dcamacho16/sdp-minihvac/docs/02-plant-model.md

# MiniHVAC_Zone Module: Physical Zone Model

## 1. Module Purpose

The **MiniHVAC_Zone** block implements the **simplified physical model** of the thermal, humidity, and airflow/ventilation dynamics of a conditioned zone.  

This module is part of the project’s **modular implementation** phase and has the following objectives:

- Continuously and simply represent the evolution of:
  - Room temperature (`T_sim`)
  - Room relative humidity (`RH_sim`)
  - Flow/“symbolic pressure” associated with the fan (`P_sim`)
- Enable **isolated validation** of the physical behavior before integrating:
  - The control logic (`Thermostat_Logic`, `Control_Simulink`)
  - The interface with the ESP32 (`ESP32_Interface`)
  - The alarm logic (`Alarms_Logic`)

---

## 2. Module Interface

The `MiniHVAC_Zone` block is implemented as a Simulink **subsystem** with the following ports:

### 2.1 Inputs (Inports)

- `T_amb`  
  Ambient temperature (°C). Represents the external environment or reference conditions.

- `RH_amb`  
  Ambient relative humidity (%). Humidity reference condition.

- `u_fan_cmd`  
  Fan command signal (dimensionless, typical range 0–1).  
  - 0 → fan off  
  - 1 → fan at 100 %  

- `u_heater_cmd`  
  Heater command signal (dimensionless, typical range 0–1).  
  - 0 → heater off  
  - 1 → heater at nominal power  

- `u_humid_cmd`  
  Humidifier command signal (dimensionless, typical range 0–1).  
  - 0 → humidifier off  
  - 1 → maximum humidity contribution  

### 2.2 Outputs (Outports)

- `T_sim`  
  Simulated room temperature (°C). Output of the thermal model.

- `RH_sim`  
  Simulated room relative humidity (%). Output of the humidity model.

- `P_sim`  
  Symbolic “pressure/flow” magnitude generated by the fan (arbitrary units), useful as an indicator of airflow or fan activity.

---

## 3. Implemented Physical Model

The module implements three submodels:

1. **Thermal model** (temperature)
2. **Humidity model** (relative humidity)
3. **Symbolic pressure/flow model**

The goal is not to build an exact industrial HVAC model, but rather a **simplified dynamic model** with a smooth response and tunable parameters, to be used as a test bench for the control algorithms.

### 3.1 Temperature Dynamics

The room temperature is modeled as a first-order system with heating input, thermal losses to the environment, and the effect of ventilation:

$$
C \, \frac{dT}{dt} = P_{heater} \, u_{heater} - k_{loss} \, (T - T_{amb}) - k_{fan} \, u_{fan} \, (T - T_{amb})
$$

where:

- $T$ : room temperature (ºC) → `T_sim`
- $T_{amb}$ : ambient temperature (ºC) → `T_amb`
- $C$ : effective thermal capacity of the room  
- $P_{heater}$ : nominal heater power
- $k_{loss}$ : thermal loss coefficient to the environment
- $k_{fan}$ : forced-exchange coefficient due to the fan
- $u_{heater}$ : heater command → `u_heater_cmd`
- $u_{fan}$ : fan command → `u_fan_cmd`

Rearranging:

$$
\frac{dT}{dt} = \frac{1}{C} \left[
P_{heater} \, u_{heater}
- k_{loss} (T - T_{amb})
- k_{fan} \, u_{fan} (T - T_{amb})
\right]
$$

In Simulink, this equation is implemented as follows:

- **Integrator**: integrates $\frac{dT}{dt}$ and outputs `T_sim`.
- Calculation of $T - T_{amb}$ using a `Sum` block of type `+ -`.
- Gains representing:
  - Thermal losses: $-k_{loss}(T - T_{amb})$
  - Fan effect: $-k_{fan} \, u_{fan} (T - T_{amb})$
- Positive heater gain: $P_{heater} \, u_{heater}$
- Sum of all contributions (heating–losses–ventilation) and multiplication by $1/C$.

#### Typical Values Used

The parameters can be adjusted according to the desired behavior. During the validation phase, values on the order of the following were tested:

- $C \in [20, 40]$  
- $k_{loss} \approx 0.05 - 0.1$
- $k_{fan} \approx 0.3 - 0.5$
- $P_{heater} \approx 5 - 15$

These ranges provide noticeable dynamics in 100–300 s simulations.

---

### 3.2 Relative Humidity Dynamics

The room relative humidity is modeled as a first-order system that tends toward ambient humidity, with an additional contribution from the humidifier:

$$
\frac{dRH}{dt} = -\frac{1}{\tau} (RH - RH_{amb}) + k_{humid} \, u_{humid}
$$

where:

- $RH$ : room relative humidity (%) → `RH_sim`
- $RH_{amb}$ : ambient relative humidity (%) → `RH_amb`
- $\tau$ : time constant for humidity exchange with the environment
- $k_{humid}$ : humidifier gain
- $u_{humid}$ : humidifier command → `u_humid_cmd`

In Simulink, the structure is analogous to the thermal model:

- **Integrator**: integrates $\frac{dRH}{dt}$ and outputs `RH_sim`.
- Calculation of $RH - RH_{amb}$ with a `Sum` block.
- Relaxation term toward the environment: $-\frac{1}{\tau}(RH - RH_{amb})$.
- Humidity contribution term: $k_{humid} \, u_{humid}$.

#### Typical Values Used

- $\tau \approx 30 - 60$ s  
- $k_{humid} \approx 0.1 - 0.3$

These values make it easy to observe convergence toward `RH_amb` and the increase in humidity when the humidifier is active.

---

### 3.3 Symbolic Pressure / Flow Dynamics

To provide a simple measure of fan activity, a symbolic magnitude $P_{sim}$ is defined:

$$
P_{sim} = k_{P} \, u_{fan}
$$

- `P_sim` is implemented with a `Gain` block that multiplies `u_fan_cmd`.
- $k_P$ can be set, for example, in the range 1–5 for visualization in the `Scope`.

This output is not intended to be an exact physical pressure measurement, but rather an airflow/ventilation indicator useful for debugging and visualization.

---

## 4. Subsystem Configuration in Simulink

For the validation phase, the `MiniHVAC_Zone` block was tested in a dedicated test model with the following recommended configuration:

- **Solver type**: Fixed-step  
- **Solver**: for example `ode3` or `ode4`
- **Integration step**: `Ts = 0.1 s`
- **Simulation time**: typically `StopTime = 200 s` (adjustable depending on the test case)

The differential equations are integrated continuously using `Integrator` blocks, which makes it possible to observe the smooth evolution of `T_sim` and `RH_sim`.

---

## 5. Module Unit Tests

Within the framework of Phase 2 (“modular implementation”), a set of **unit tests** was designed to validate the model behavior before integrating it with the rest of the subsystems.

Each test consists of:

- Connecting the `MiniHVAC_Zone` block to a set of `Constant` blocks.
- Visualizing the outputs (`T_sim`, `RH_sim`, `P_sim`) with `Scope`.
- Adjusting the initial conditions of the integrators (initial room temperature and humidity).

### 5.1 Test 1: Baseline Case Without Actuators

**Objective:** verify that, in the absence of actuators, the room remains at ambient conditions.

- `T_amb = 22 °C`
- `RH_amb = 50 %`
- `u_fan_cmd = 0`
- `u_heater_cmd = 0`
- `u_humid_cmd = 0`
- Initial conditions:
  - `T_sim(0) = 22 °C`
  - `RH_sim(0) = 50 %`

**Expected behavior:**

- `T_sim` remains approximately constant at 22 °C.
- `RH_sim` remains approximately constant at 50 %.
- `P_sim = 0` (fan off).

This test confirms that the model does not introduce spurious dynamics when the system is in equilibrium with the environment.

---

### 5.2 Test 2: Passive Cooling (Without Fan)

**Objective:** validate thermal losses to the environment with the fan turned off.

- `T_amb = 22 °C`
- `u_heater_cmd = 0`
- `u_fan_cmd = 0`
- `u_humid_cmd = 0`
- Initial condition:
  - `T_sim(0) = 28 °C` (> `T_amb`)

**Expected behavior:**

- `T_sim` decreases smoothly from 28 °C toward 22 °C.
- The cooling rate depends on $C$ and $k_{loss}$.
- `RH_sim` remains at the initial test condition (if no difference with `RH_amb` is forced in this scenario).
- `P_sim = 0`.

This test verifies that the loss term $-k_{loss}(T - T_{amb})$ is correctly implemented and has the correct sign.

---

### 5.3 Test 3: Fan Effect

**Objective:** verify that the fan accelerates cooling when the room temperature is higher than the ambient temperature.

- `T_amb = 22 °C`
- `u_heater_cmd = 0`
- `u_fan_cmd = 1`
- `u_humid_cmd = 0`
- Initial condition:
  - `T_sim(0) = 28 °C`

**Expected behavior:**

- `T_sim` decreases toward 22 °C **faster** than in Test 2.
- Comparing the `T_sim` curves from Tests 2 and 3 clearly shows the additional effect of $-k_{fan} u_{fan} (T - T_{amb})$.
- `P_sim` takes a nonzero value (proportional to `u_fan_cmd`), indicating that the fan is active.

In addition, if `T_sim` starts equal to `T_amb`, the term $(T - T_{amb})$ is zero and the fan has no effect on temperature, which is physically consistent.

---

### 5.4 Test 4: Heater On

**Objective:** validate the effect of the heater on the room temperature.

- `T_amb = 22 °C`
- `u_heater_cmd = 1`
- `u_fan_cmd = 0`
- `u_humid_cmd = 0`
- Initial condition:
  - `T_sim(0) = 22 °C`

**Expected behavior:**

- `T_sim` increases from 22 °C, initially with an approximately slope:
  $$
  \left. \frac{dT}{dt} \right|_{t=0} \approx \frac{P_{heater}}{C}
  $$
- As `T_sim` moves away from `T_amb`, the losses $-k_{loss}(T - T_{amb})$ increase in magnitude and tend to limit the temperature increase.
- By adjusting `P_{heater}` and `C`, a useful dynamic response can be obtained for control tests (neither too slow nor unstable).

---

### 5.5 Humidity Tests

**Objective:** validate the convergence of `RH_sim` toward `RH_amb` and the effect of the humidifier.

1. **Relaxation toward ambient humidity**

   - `RH_amb = 50 %`
   - `u_humid_cmd = 0`
   - Initial condition: `RH_sim(0) = 70 %`

   *Expected behavior:* `RH_sim` decreases smoothly from 70 % toward 50 % with an approximate time constant $\tau$.

2. **Humidifier contribution**

   - `RH_amb = 50 %`
   - `u_humid_cmd = 0.5` (for example)
   - Initial condition: `RH_sim(0) = 40 %`

   *Expected behavior:* `RH_sim` increases from 40 %, reaching an equilibrium value that depends on $\tau$ and $k_{humid}$. The system should not diverge; it should stabilize at a humidity level higher than the ambient value.

---

## 6. Connection with Other Project Modules

In Phase 2, `MiniHVAC_Zone` is used **independently** for validation, but it is designed to integrate with the following modules:

- **`Thermostat_Logic`**  
  Generates the reference signals and operating mode (AUTO/MANUAL). Based on the temperature error, it produces logical or continuous commands that will be converted into `u_heater_cmd`, `u_fan_cmd`, and `u_humid_cmd`.

- **`Control_Simulink` (PID or another controller)**  
  Based on the difference between the desired temperature and `T_sim`, it computes analog control signals (for example, normalized PWM) that will be connected directly to the inputs:
  - `u_heater_cmd`
  - `u_fan_cmd`
  - `u_humid_cmd`

- **`ESP32_Interface`**  
  This module will be responsible for sending/receiving measurements and setpoints between the model and the ESP32 (for example, through serial communication or UDP). In the pure simulation phase, `T_sim` and `RH_sim` represent the “measurements” that the microcontroller would read from real sensors.

- **`Alarms_Logic`**  
  This module will be able to use `T_sim`, `RH_sim`, and the command signals to generate alarms (overtemperature, humidity out of range, actuator failure, etc.).

---

## 7. Module Conclusions

- The `MiniHVAC_Zone` block provides a **simplified but configurable physical model** of the thermal and humidity dynamics of an HVAC zone.
- It has been explicitly designed to:
  - Support **modular implementation** in Simulink.
  - Enable isolated **unit tests**, verifying the behavior of each input (fan, heater, humidifier) on the outputs.
  - Serve as the basis for **subsequent integration** with the control logic in Simulink and with the ESP32.

This module constitutes the project’s **physical core**, on which the controllers and the interface with the real hardware will rely in the following phases.
