dcamacho16/sdp-minihvac/schematics/Arquitectura de sistema - diagrama.pdf

┌──────────────────────────┐
│ | Usuario | │
│ • Alumno / Operador | │
│ • Interacción con PC | │
│ • Lectura LCD / LEDs | │
└──────────┬──────────────┘
│
│ (Panel Simulink, LCD, botones)
│
┌─────────────────┴─────────────────┐
│ | Capa de Control | │
│ | (PC con MATLAB/Simulink) | │
│ | │
│ ┌─────────────────────────────┐ │
│ │ | Modelo MiniHVAC_Zone | │ │
│ │ (planta T_sim, RH_sim, P) | │ │
│ └──────────────┬──────────────┘ │
│ | │ T_sim, RH_sim | │
│ ┌──────────────▼──────────────┐ │
│ │ | Thermostat_Logic | │ │
│ │ (setpoints, modos, lógica | │ │
│ │ on/off, estados HVAC) | │ │
│ └──────────────┬──────────────┘ │
│ | │ u_fan_cmd, | │
│ | │ u_heater_cmd, | │
│ | │ u_humid_sim(*) │
│ ┌──────────────▼──────────────┐ │
│ │ | Control_Simulink | │ │
│ │ (PI/PID T y RH, generación │ │
│ │ | de señales de mando) | │ │
│ └──────────────┬──────────────┘ │
│ | │ comandos / ref. │
│ ┌──────────────▼──────────────┐ │
│ │ | Alarms_Logic | │ │
│ │ (detección alarmas, | │ │
│ │ alarm_flag, señales fallo) │ │ │ └──────────────┬──────────────┘ │
│ | │ PcToEsp / Pc←Esp│
│ ┌──────────────▼──────────────┐ │
│ │ | ESP32_Interface | │ │
│ │ (codificación/decodificación│ │ │ │ structs PcToEsp / EspToPc, │ │
│ │ UART Serial) | │ │
│ └──────────────┬──────────────┘ │ └─────────────────│─────────────────┘ │ 24B / 32B UART
│ (PcToEsp / EspToPc)
│

┌─────────────────▼─────────────────┐
│ | Capa Embebida (ESP32) | │
│ | + FreeRTOS | │
│ | │
│ ┌──────────────┐ ┌────────────┐ │
│ │ TaskRX | │ │ TaskTX | │ │
│ │ (UART RX → | │ │ (espState │ │
│ │ pcCmd) | │ │ → UART TX)│ │
│ └──────┬───────┘ └─────┬──────┘ │
│ | │ pcCmd | │ espState│
│ ┌──────▼───────┐ ┌─────▼───────┐│
│ │ TaskSensores │ │ TaskLCD | ││
│ │ (BMP/BME, | │ │ (info T/RH, ││
│ │ DHT11, etc) │ │ modo, alarm││ │ └──────┬───────┘ └─────┬───────┘│
│ | │ T_real,RH_real │ | │
│ | └──────┬─────────┘ | │

│ | │ espState | │
│ | ┌────────▼────────┐ | │
│ | │ | Actuadores | │ | │
│ | │ (ventilador, | │ | │
│ | │ resistencia, | │ | │
│ | │ humidificador) │ | │
│ | └────────┬────────┘ | │
└────────────────│───────────────────┘
│
│ Flujo de calor / humedad / aire
│

┌─────────▼───────────┐
│ | Entorno físico | │
│ | (Mini-HVAC real: │
│ | maqueta, cuarto) │
└─────────────────────┘
