dcamacho16/sdp-minihvac/images/f2-alarms-logic-high-temperature-threshold-scope.png

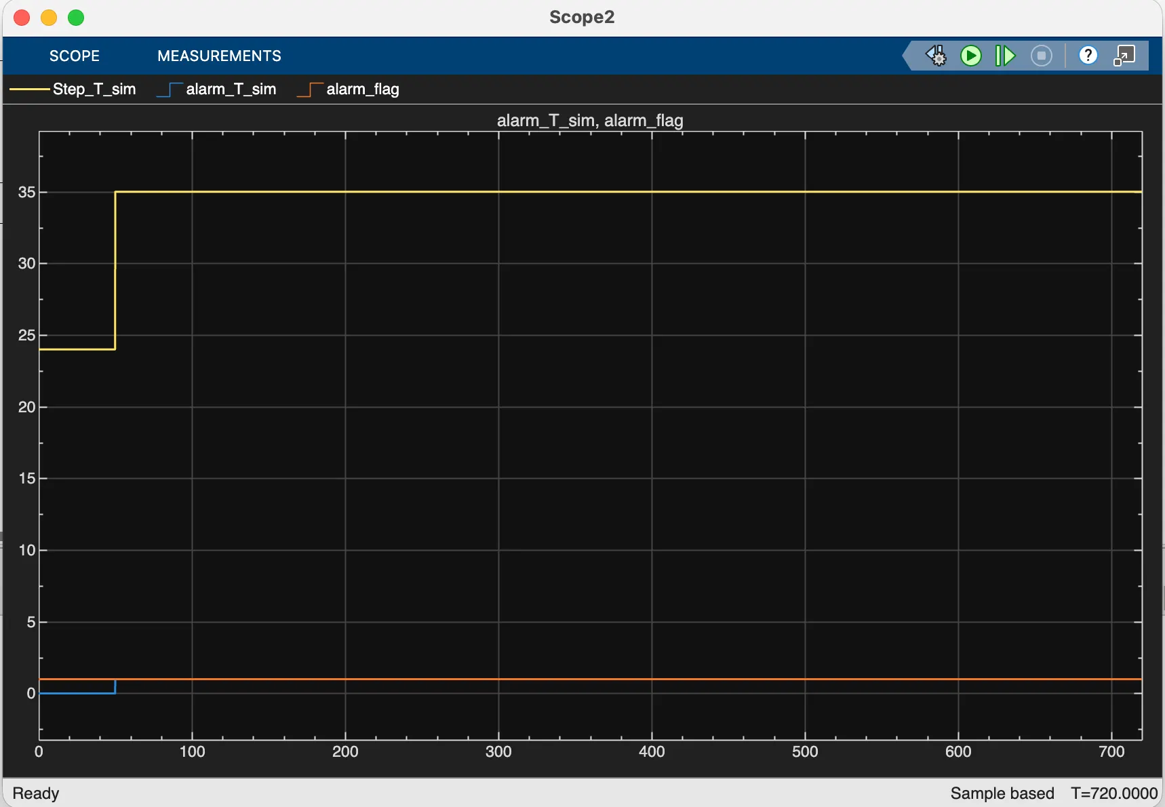
images/f2-alarms-logic-high-temperature-threshold-scope.png
