dcamacho16/sdp-minihvac/images/f2-control-simulink-closed-loop-scope.png

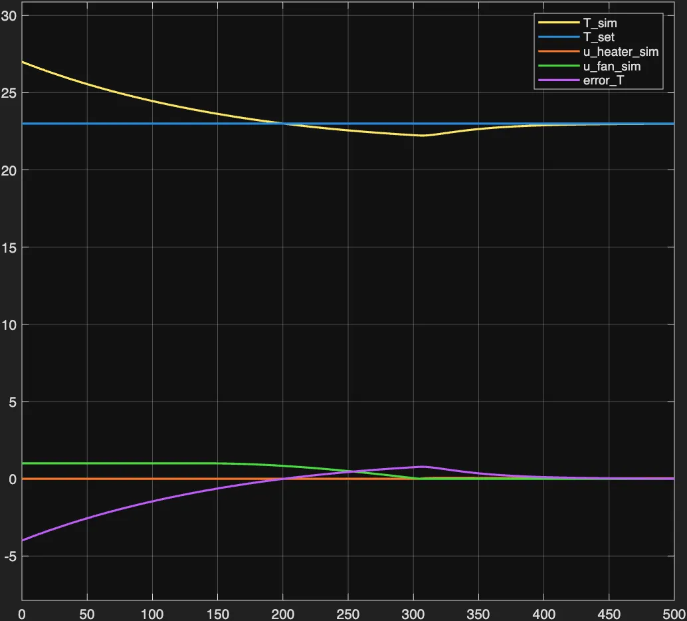
images/f2-control-simulink-closed-loop-scope.png
