dcamacho16/sdp-minihvac/images/f2-control-simulink-temperature-error-correction-scope.png

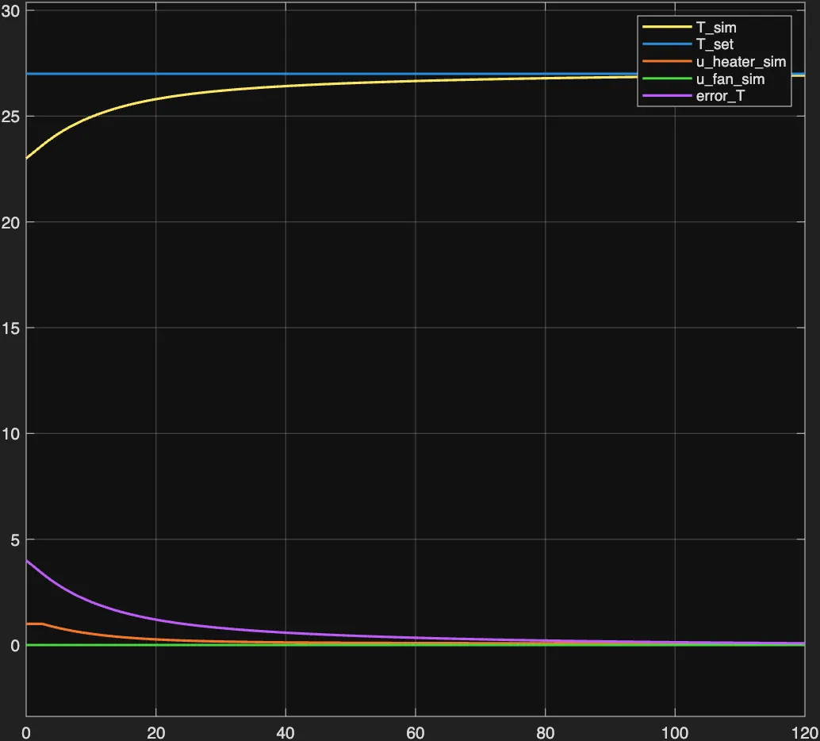
images/f2-control-simulink-temperature-error-correction-scope.png
