dcamacho16/sdp-minihvac/images/f2-freertos-serial-temperature-log.png

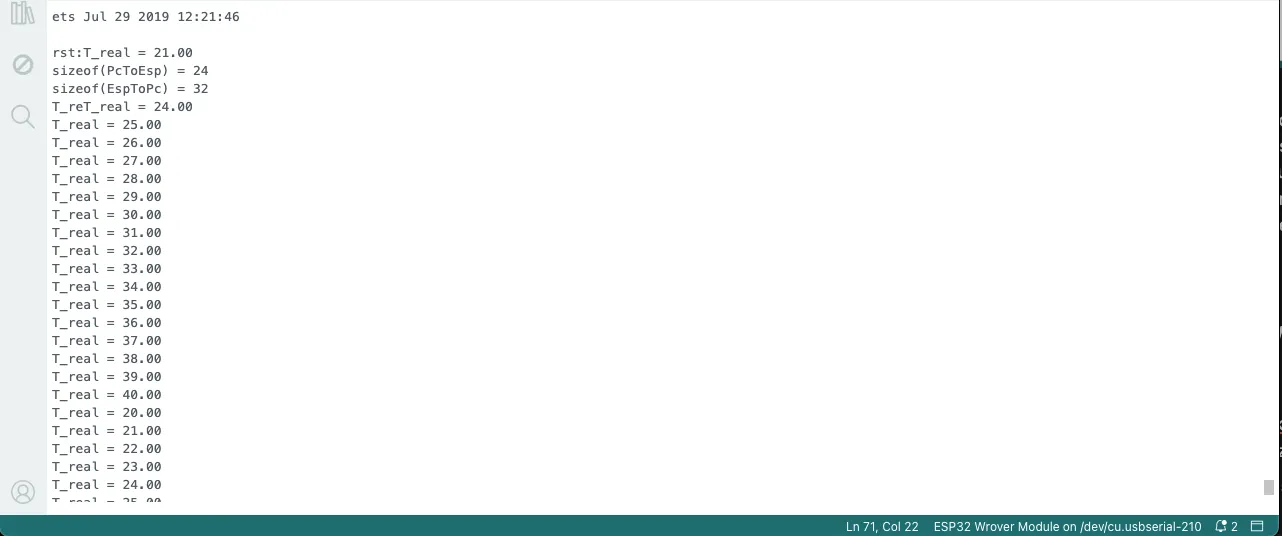
images/f2-freertos-serial-temperature-log.png
