dcamacho16/sdp-minihvac/images/f2-minihvac-zone-fan-effect-scope.png

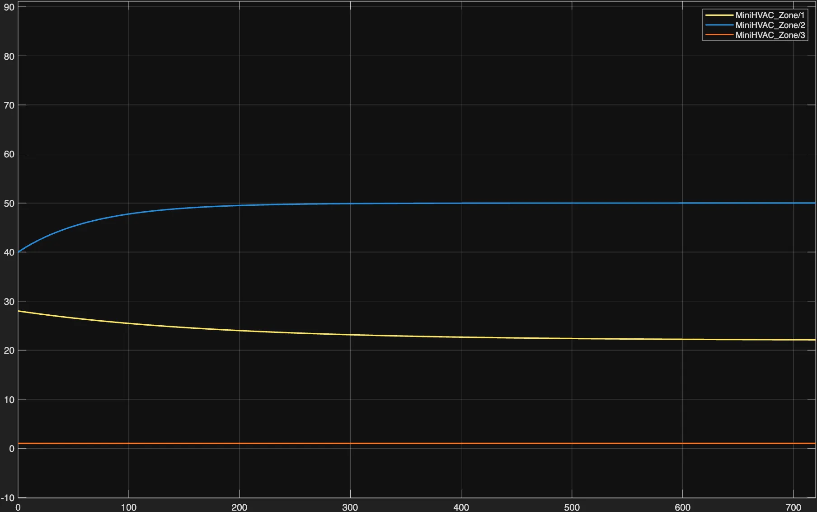
images/f2-minihvac-zone-fan-effect-scope.png
