dcamacho16/sdp-minihvac/images/f2-minihvac-zone-heater-on-scope.png

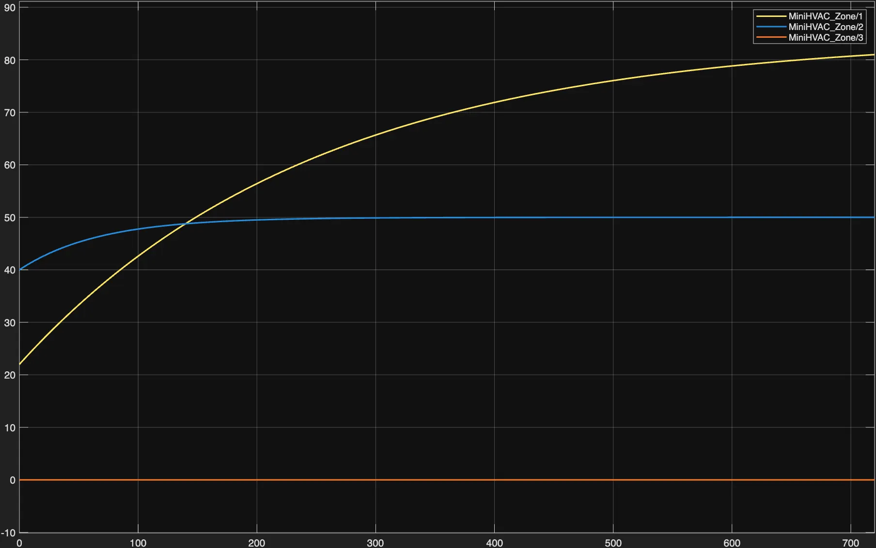
images/f2-minihvac-zone-heater-on-scope.png
