dcamacho16/sdp-minihvac/images/f2-minihvac-zone-humidity-no-humidifier-scope.png

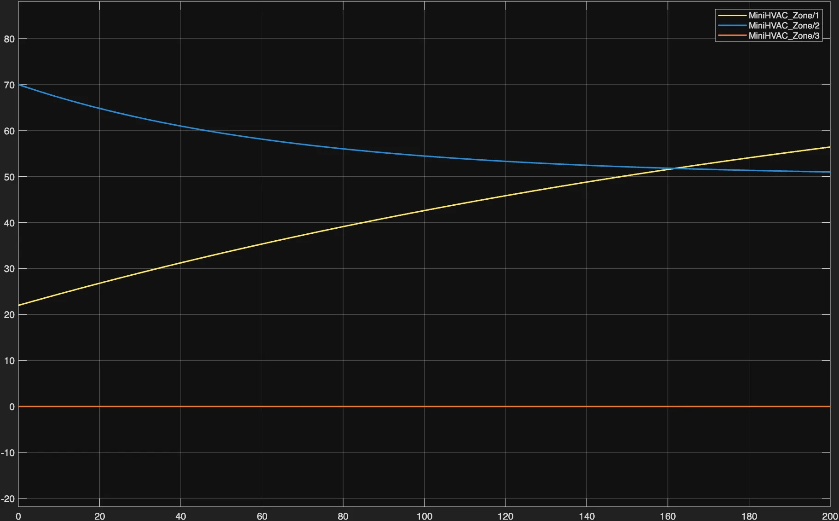
images/f2-minihvac-zone-humidity-no-humidifier-scope.png
