dcamacho16/sdp-minihvac/images/f2-rx-from-esp32-temperature-scope.png

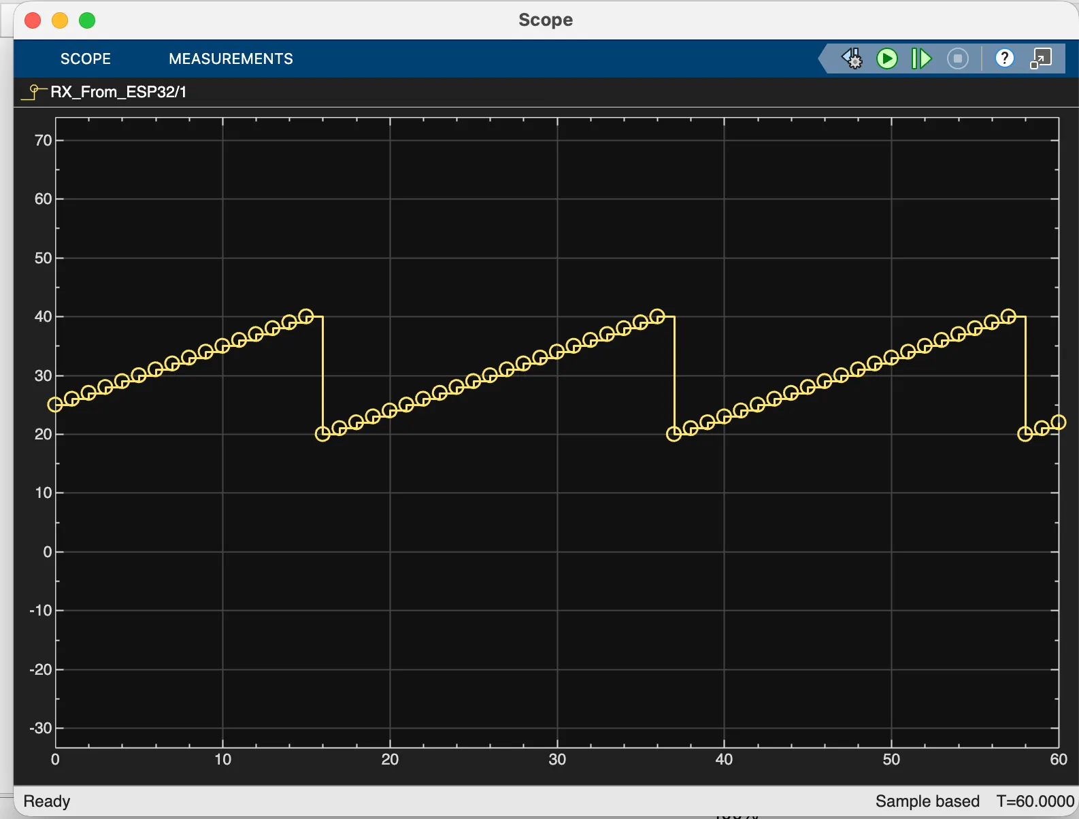
images/f2-rx-from-esp32-temperature-scope.png
