dcamacho16/sdp-minihvac/images/F4_Prototipo_Final_VistaAerea.jpeg

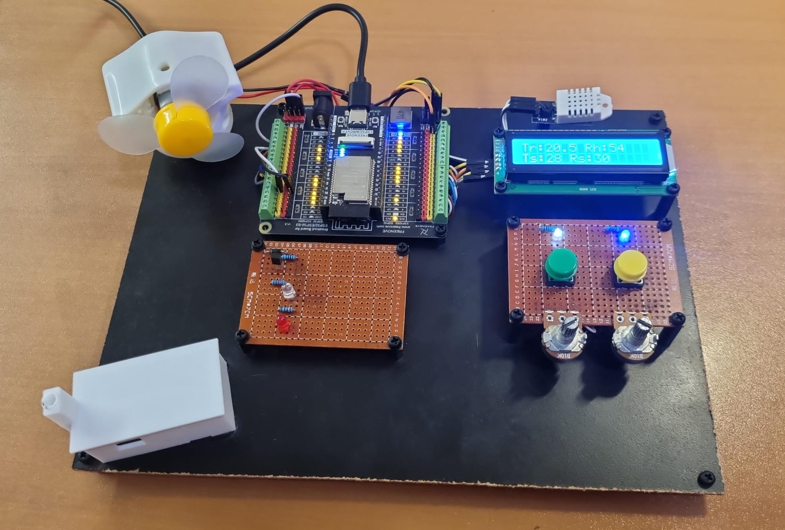
images/F4_Prototipo_Final_VistaAerea.jpeg
