dcamacho16/sdp-minihvac/schematics/conexion final 2.png

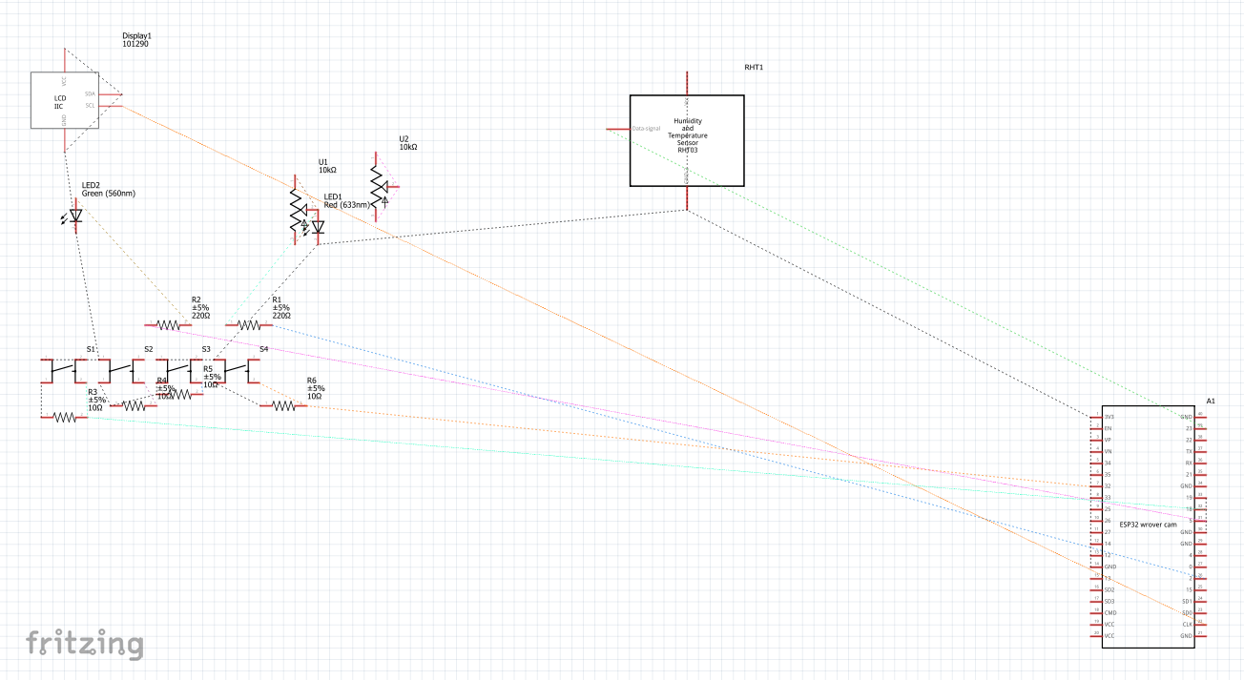
schematics/conexion final 2.png
