dcamacho16/sdp-minihvac/schematics/conexion final 3.png

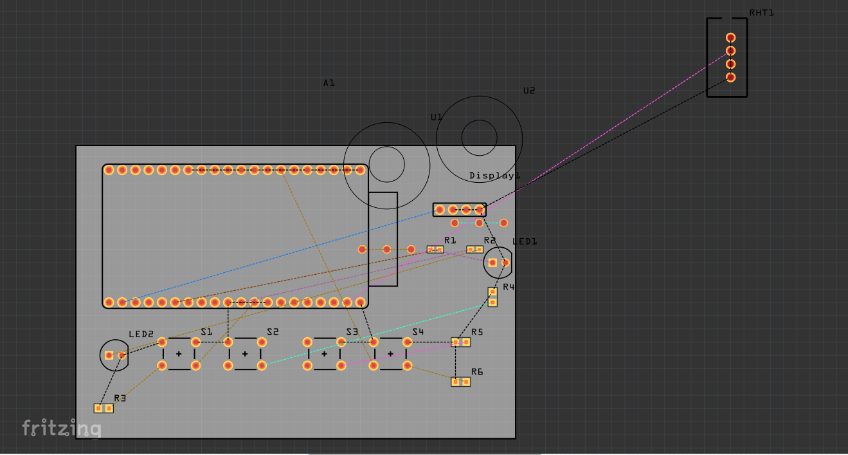
schematics/conexion final 3.png
