dcamacho16/sdp-minihvac/schematics/conexion final 4.png

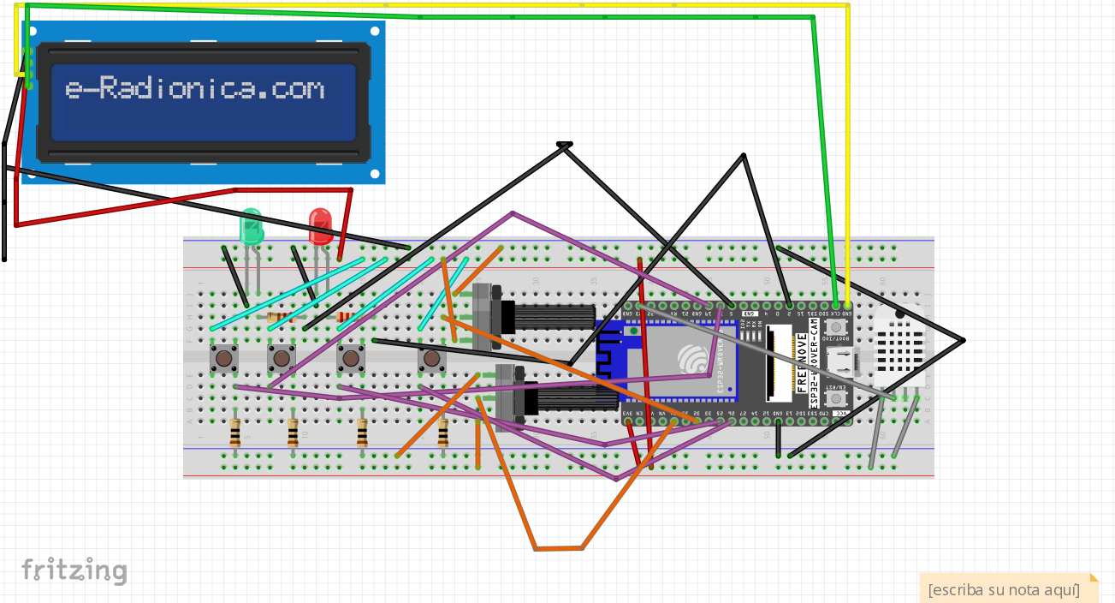
schematics/conexion final 4.png
