dcamacho16/sdp-minihvac/schematics/conexión final.png

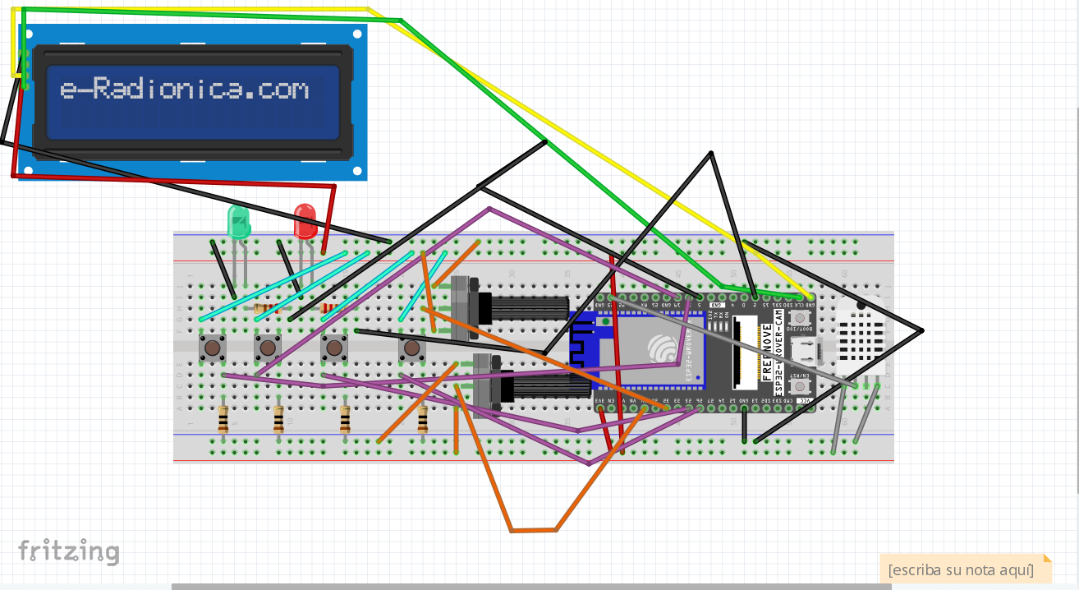
schematics/conexión final.png
