dcamacho16/sdp-minihvac/schematics/conexión final_bb.png

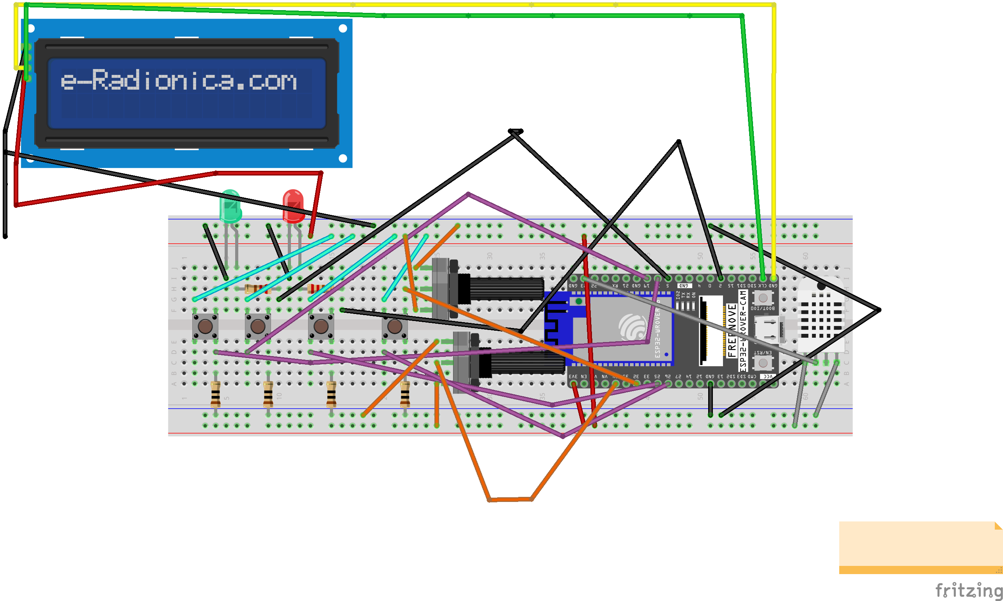
schematics/conexión final_bb.png
