dcamacho16/sdp-minihvac/schematics/conexión final_schem.png

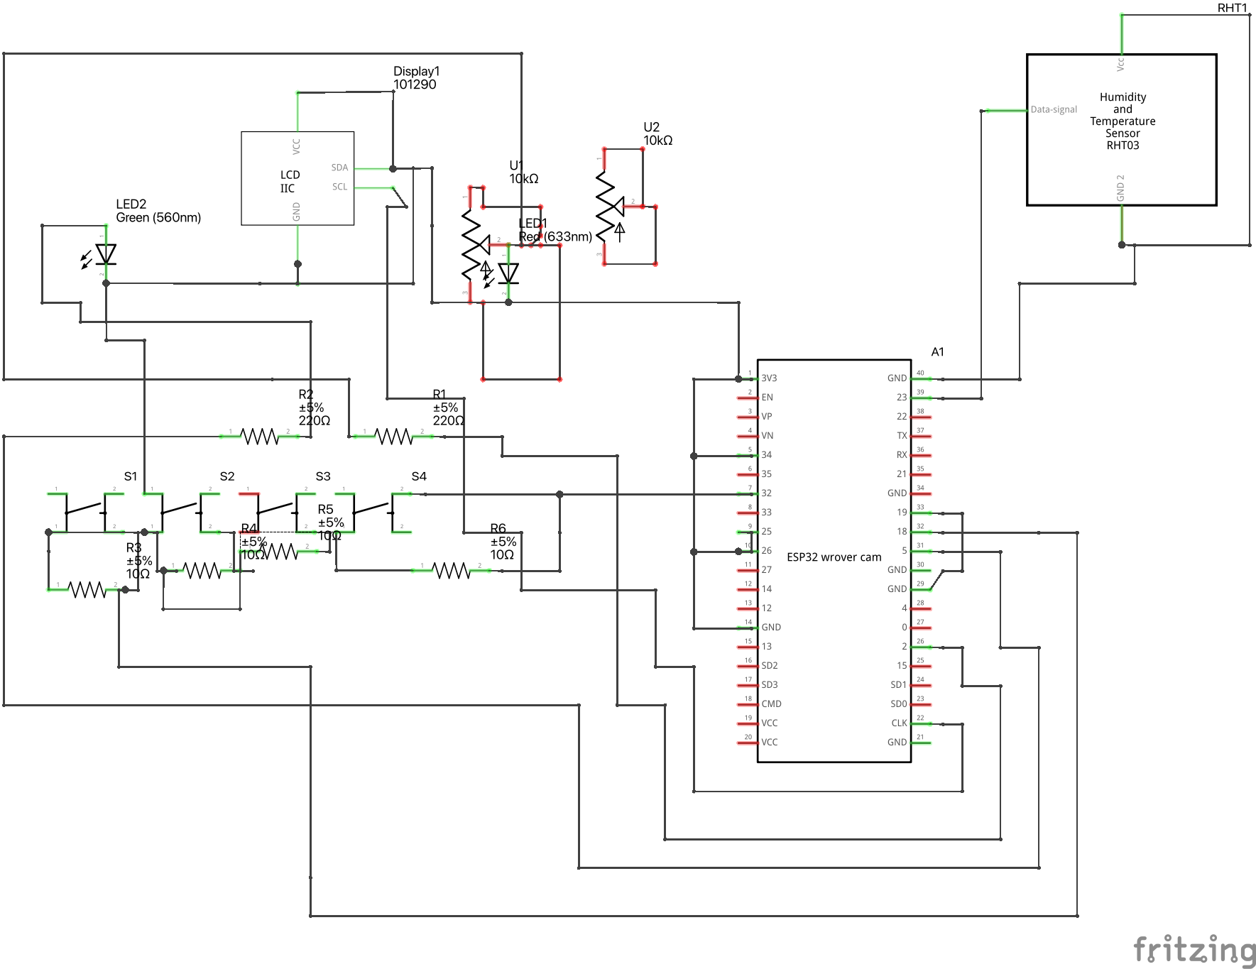
schematics/conexión final_schem.png
