dcamacho16/sdp-minihvac/images/f2-thermostat-logic-humidity-manual-scope.png

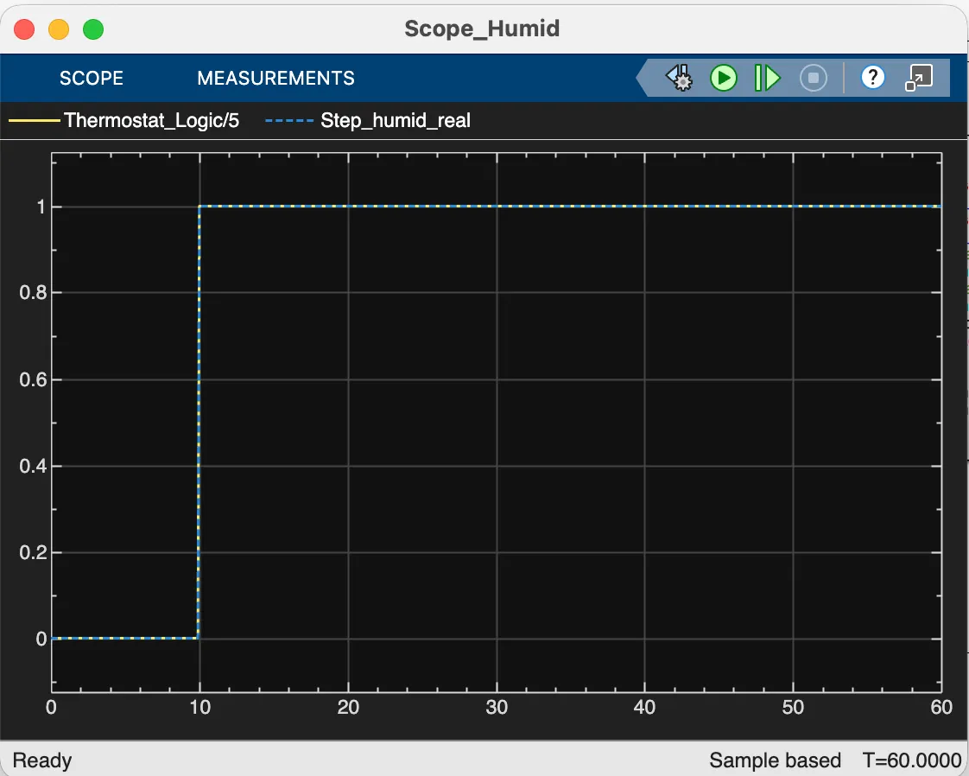
images/f2-thermostat-logic-humidity-manual-scope.png
