dcamacho16/sdp-minihvac/images/f2-rx-from-esp32-byte-unpack-test.png

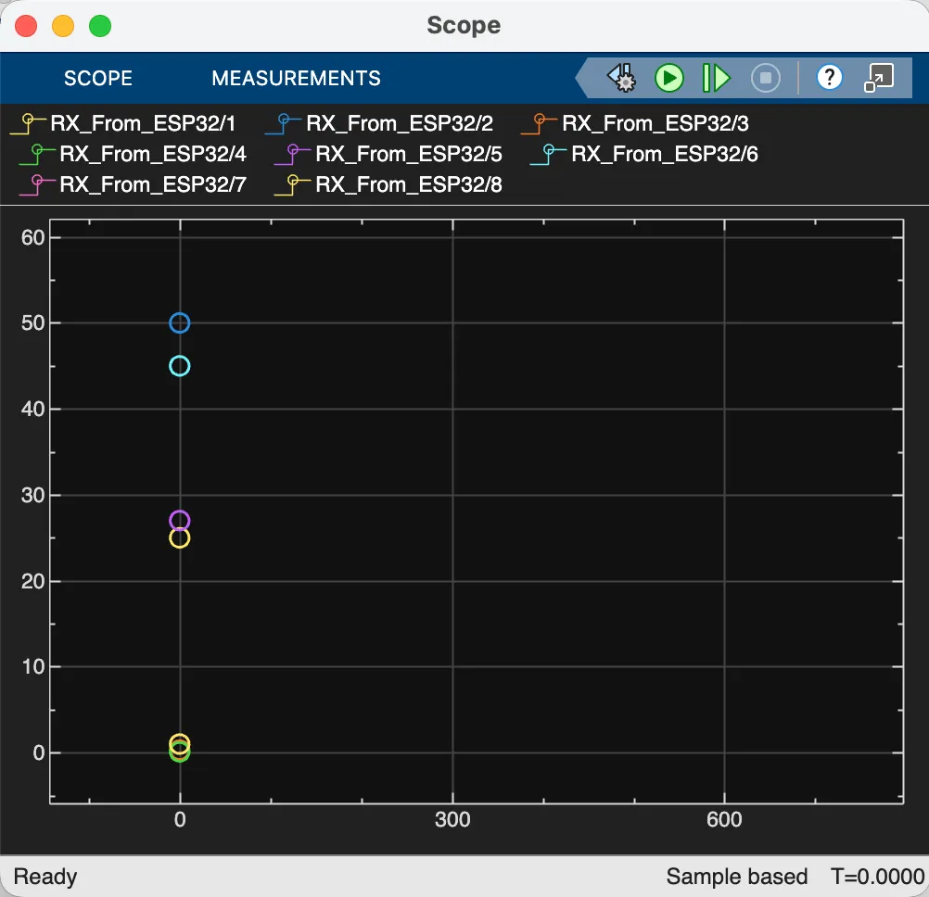
images/f2-rx-from-esp32-byte-unpack-test.png
