dcamacho16/sdp-minihvac/images/f2-tx-to-esp32-byte-pack-test.png

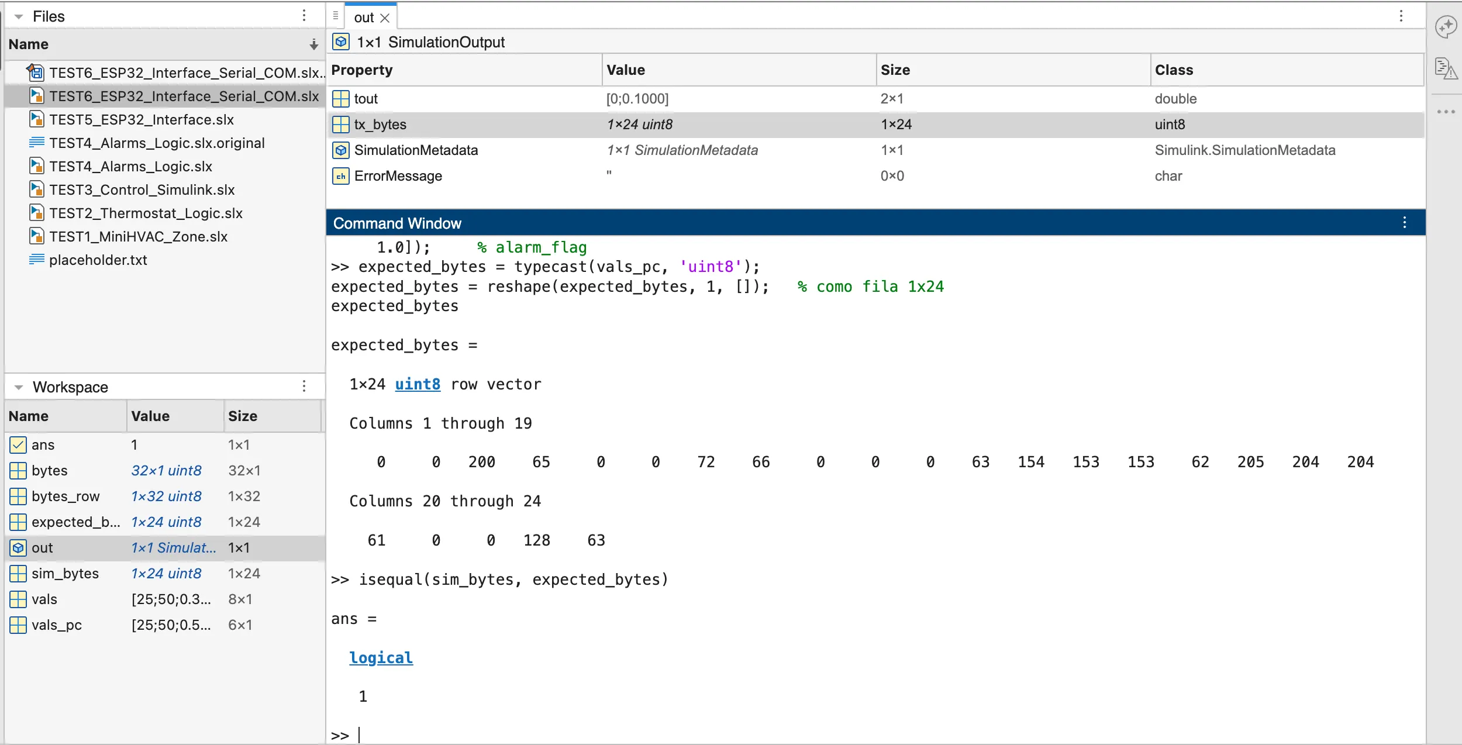
images/f2-tx-to-esp32-byte-pack-test.png
