dcamacho16/sdp-minihvac/(commit log)

2025-12-05 Phase 2: architecture diagrams, basic firmware sketches, serial communication, alarm and interface docs, schematics
2025-12-15 Phase 3: DHT22 temperature/humidity sensor bring-up sketch
2026-01-08 Phase 4: FreeRTOS integration v1+v2, LCD bring-up, integrated firmware with TaskLCD, RX model, prototype photos
2026-01-09 Phase 4: final delivery — top-level Simulink model, delivered firmware, FreeRTOS architecture docs
